Electrium-Mobility/power-distribution-antispark/Power_Distribution_Antispark.kicad_pcb

## KiCad design Power_Distribution_Antispark.kicad_pcb (2026-06-22)

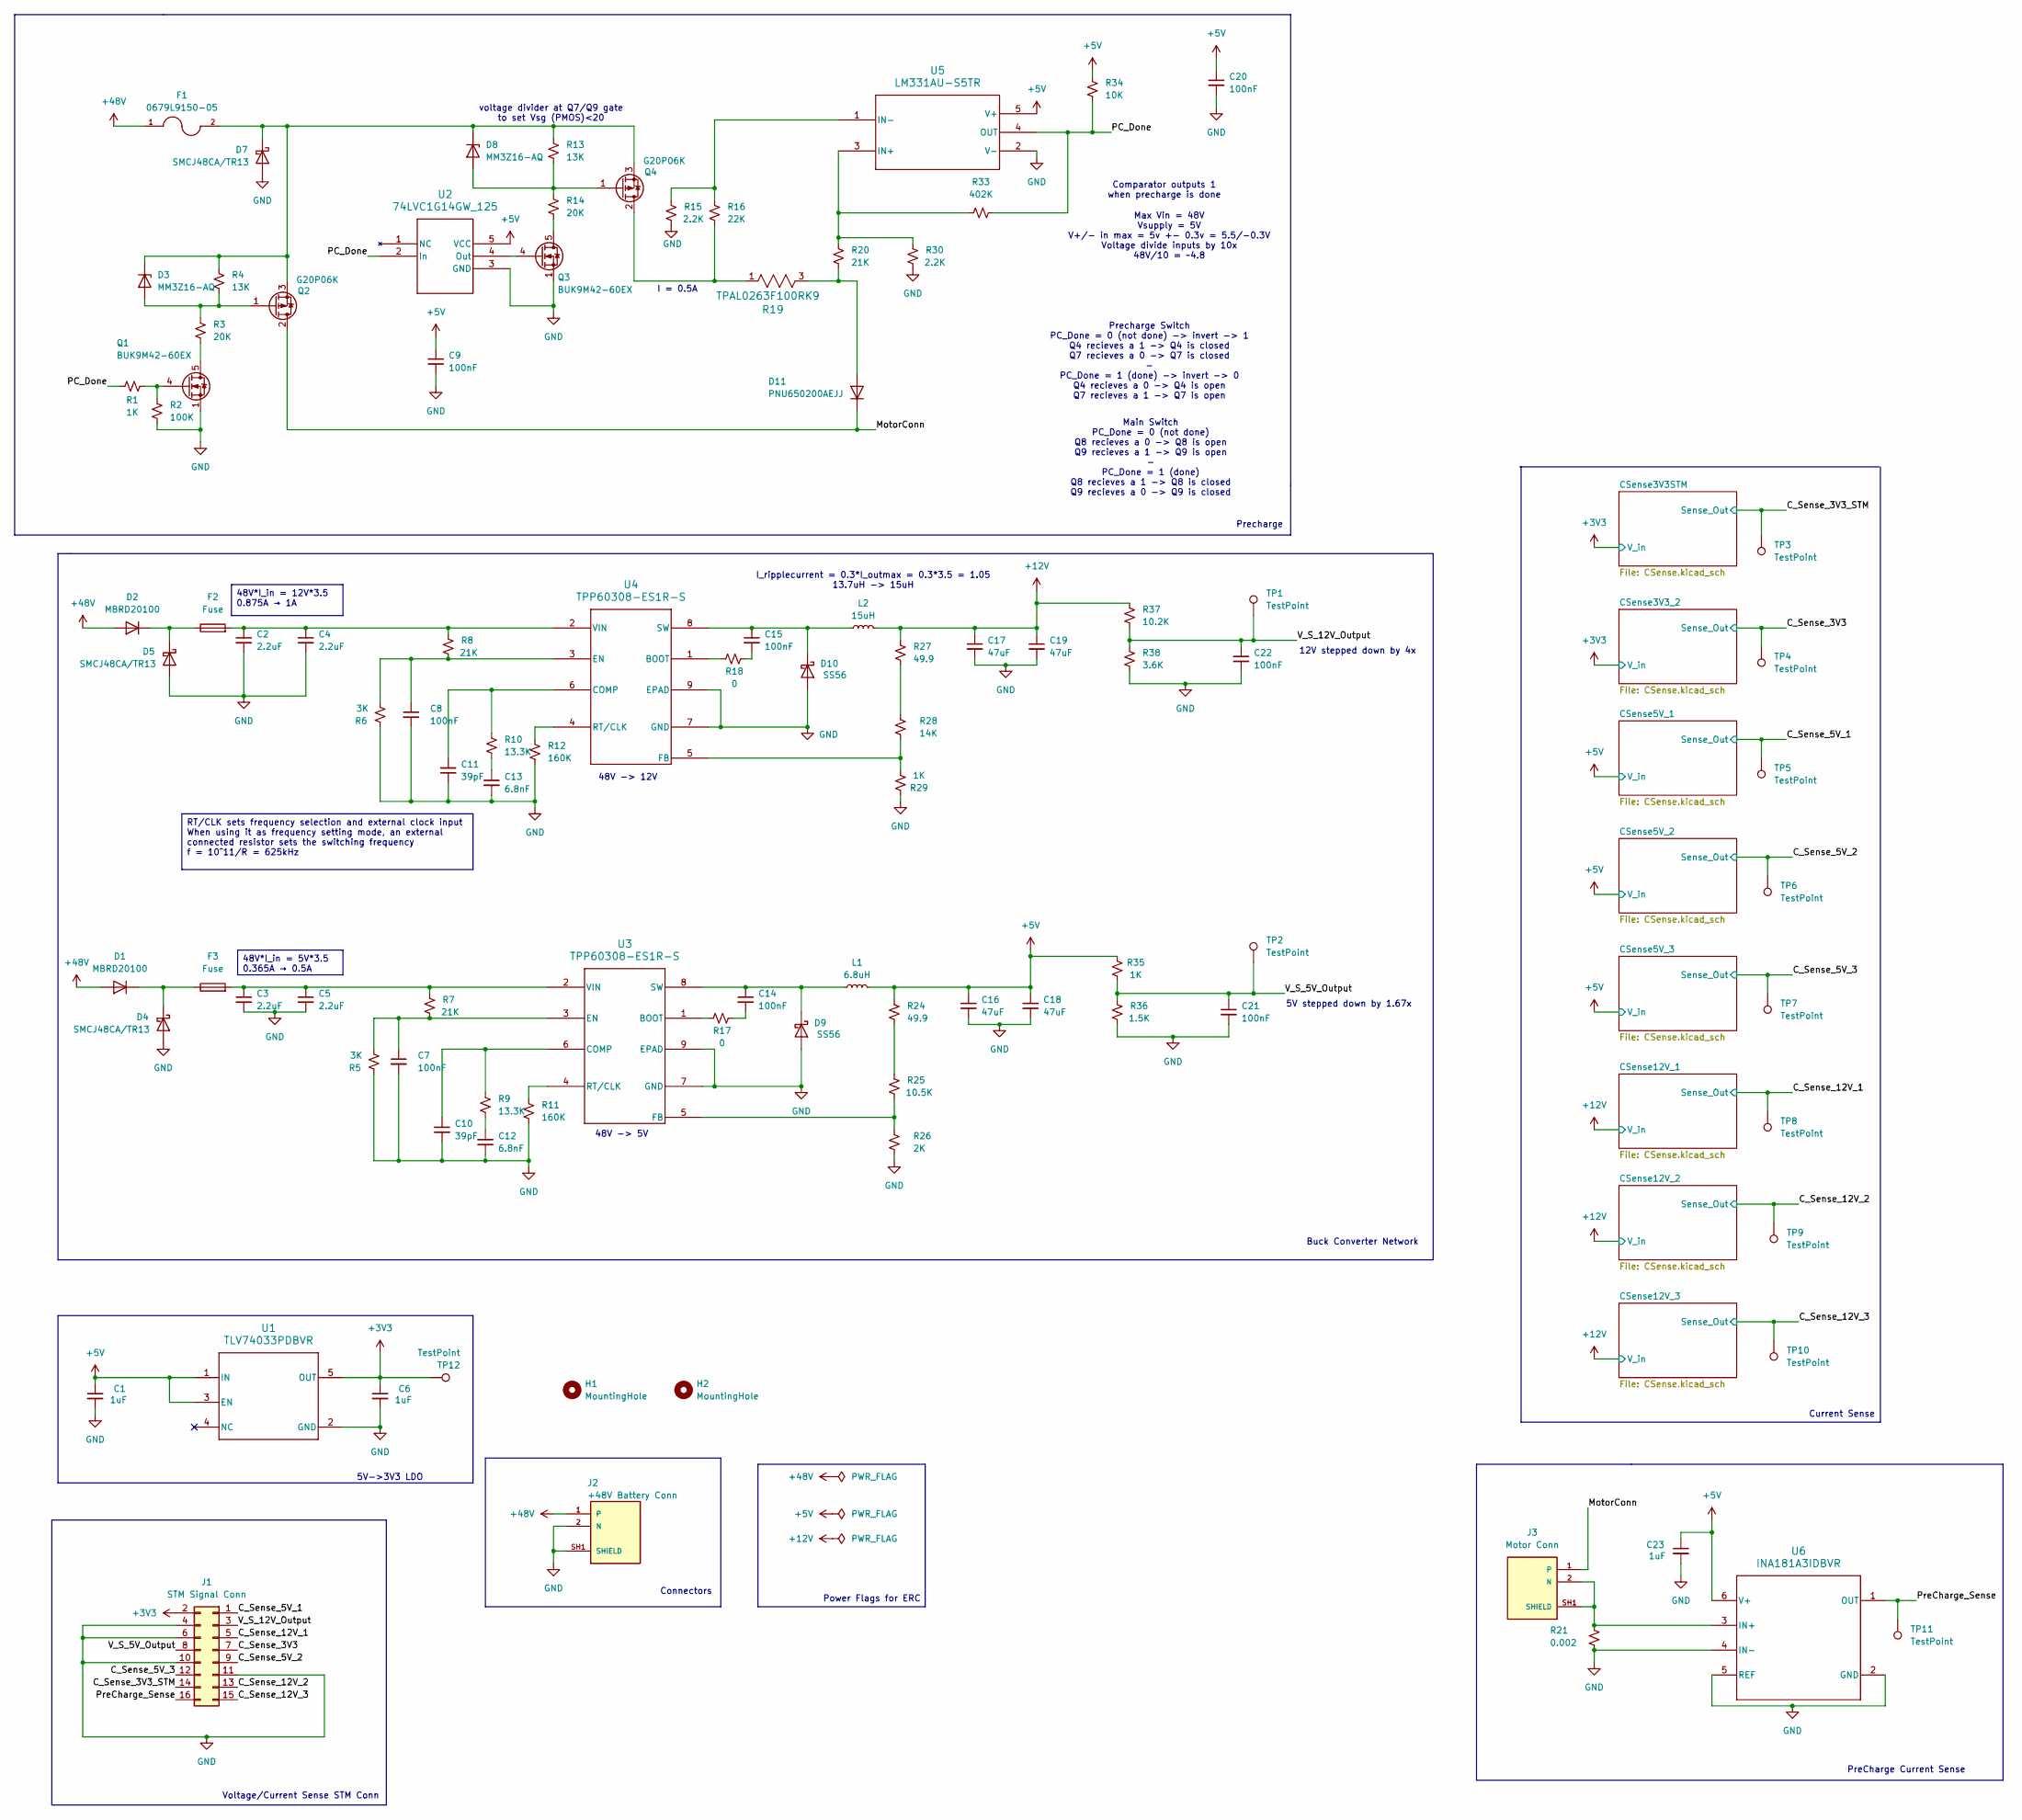
[picture p1: schematic Power_Distribution_Antispark.kicad_sch, Power Distribution Antispark]

Parts:
C1, C6, C23: 1uF; C_0603_1608Metric
C2, C3, C4, C5: 2.2uF; C_1206_3216Metric
C7, C8, C9, C14, C15, C20, C21, C22: 100nF; C_0603_1608Metric
C10, C11: 39pF; C_0603_1608Metric
C12, C13: 6.8nF; C_0603_1608Metric
C16, C17, C18, C19: 47uF; C_1206_3216Metric
D1, D2: MBRD20100; TO-252-3_TabPin2
D3, D8: MM3Z16-AQ; D_SOD-323F
D4, D5, D7: SMCJ48CA/TR13; D_SMC
D9, D10: SS56; D_SMA
D11: PNU650200AEJJ; TO-263-3_TabPin2
F1: 0679L9150-05; FUSE_0679L9200-05_BEL; PARTREV 0679H Apr2019
F2, F3: Fuse; Fuse_0603_1608Metric
H1, H2: MountingHole; MountingHole_2.5mm
J1: STM Signal Conn; CONN16_B16B-PHDSS_JST
J2: +48V Battery Conn; AMASS_XT60PW-F; PARTREV 1.2
J3: Motor Conn; AMASS_XT60PW-F; PARTREV 1.2
L1: 6.8uH; IND_MGAH06036R8M-10
L2: 15uH; IND_AMRM00101040_PUL-AMRM00101040150MA1
Q1, Q3: BUK9M42-60EX; LFPAK33
Q2, Q4: G20P06K; TO-252-3_TabPin2
R1, R29, R35: 1K; R_0603_1608Metric
R2: 100K; R_0603_1608Metric
R3, R14: 20K; R_0603_1608Metric
R4, R13: 13K; R_0603_1608Metric
R5, R6: 3K; R_0603_1608Metric
R7, R8, R20: 21K; R_0603_1608Metric
R9, R10: 13.3K; R_0603_1608Metric
R11, R12: 160K; R_0603_1608Metric
R15, R30: 2.2K; R_0603_1608Metric
R16: 22K; R_0603_1608Metric
R17, R18: 0; R_0603_1608Metric
R19: TPAL0263F100RK9; TO-263-2
R21: 0.002; R_0805_2012Metric
R24, R27: 49.9; R_0603_1608Metric
R25: 10.5K; R_0603_1608Metric
R26: 2K; R_0603_1608Metric
R28: 14K; R_0603_1608Metric
R33: 402K; R_0603_1608Metric
R34: 10K; R_0603_1608Metric
R36: 1.5K; R_0603_1608Metric
R37: 10.2K; R_0603_1608Metric
R38: 3.6K; R_0603_1608Metric
TP1, TP2, TP3, TP4, TP5, TP6, TP7, TP8, TP9, TP10, TP11, TP12: TestPoint; TestPoint_Pad_D1.0mm
U1: TLV74033PDBVR
U2: 74LVC1G14GW_125; SOT353_NEX
U3, U4: TPP60308-ES1R-S; ES1ESOP-8-F_TPK
U5: LM331AU-S5TR; S5TSOT23-5-A_TPK
U6: INA181A3IDBVR

Connections:
+3V3: C6.1, J1.2, TP12.1, U1.5 (OUT); also elsewhere on the board
+5V: C1.1, C9.1, C16.1, C18.1, C20.1, C23.1, L1.2, R24.1, R34.1, R35.2, U1.1 (IN), U1.3 (EN), U2.5 (VCC), U5.5 (V+), U6.6 (V+); also elsewhere on the board
+12V: C17.1, C19.1, L2.2, R27.1, R37.1; also elsewhere on the board
+48V: D1.2 (A), D2.2 (A), F1.1, J2.1
/C_Sense_3V3: J1.7, TP4.1; also elsewhere on the board
/C_Sense_3V3_STM: J1.14, TP3.1; also elsewhere on the board
/C_Sense_5V_1: J1.1, TP5.1; also elsewhere on the board
/C_Sense_5V_2: J1.9, TP6.1; also elsewhere on the board
/C_Sense_5V_3: J1.12, TP7.1; also elsewhere on the board
/C_Sense_12V_1: J1.5, TP8.1; also elsewhere on the board
/C_Sense_12V_2: J1.13, TP9.1; also elsewhere on the board
/C_Sense_12V_3: J1.15, TP10.1; also elsewhere on the board
/MotorConn: D11.1 (K), J3.1, Q2.2 (D)
/PC_Done: R1.1, R33.2, R34.2, U2.2 (In), U5.4 (OUT)
/PreCharge_Sense: J1.16, TP11.1, U6.1 (OUT)
/V_S_5V_Output: C21.1, J1.8, R35.1, R36.2, TP2.1
/V_S_12V_Output: C22.1, J1.3, R37.2, R38.1, TP1.1
GND: C1.2, C2.2, C3.2, C4.2, C5.2, C6.2, C7.2, C8.2, C9.2, C10.2, C11.2, C12.2, C13.2, C16.2, C17.2, C18.2, C19.2, C20.2, C21.2, C22.2, C23.2, D4.2 (A), D5.2 (A), D7.2 (A), D9.2 (A), D10.2 (A), J1.4, J1.6, J1.10, J1.11, J2.2 (N), J2.SH1 (SHIELD), J2.SH2 (SHIELD), Q1.1 (S), Q1.2 (S), Q1.3 (S), Q3.1 (S), Q3.2 (S), Q3.3 (S), R2.1, R5.2, R6.2, R11.2, R12.2, R15.1, R21.2, R26.2, R29.1, R30.1, R36.1, R38.2, U1.2 (GND), U2.3 (GND), U3.7 (GND), U3.9 (EPAD), U4.7 (GND), U4.9 (EPAD), U5.2 (V-), U6.2 (GND), U6.4 (IN-), U6.5 (REF); also elsewhere on the board
unnamed: C12.1, R9.2
unnamed: C13.1, R10.2
unnamed: C14.2, R17.2
unnamed: C15.2, R18.2
unnamed: D1.1 (K), D4.1 (K), F3.1
unnamed: D2.1 (K), D5.1 (K), F2.1
unnamed: D3.2 (A), Q2.1 (G), R3.2, R4.2
unnamed: D3.1 (K), D7.1 (K), D8.1 (K), F1.2, Q2.3 (S), Q4.3 (S), R4.1, R13.1
unnamed: D8.2 (A), Q4.1 (G), R13.2, R14.2
unnamed: C14.1, D9.1 (K), L1.1, U3.8 (SW)
unnamed: C15.1, D10.1 (K), L2.1, U4.8 (SW)
unnamed: D11.2 (A), R19.3, R20.1
unnamed: J3.2 (N), J3.SH1 (SHIELD), J3.SH2 (SHIELD), R21.1, U6.3 (IN+)
unnamed: Q1.5 (D), R3.1
unnamed: Q1.4 (G), R1.2, R2.2
unnamed: Q3.5 (D), R14.1
unnamed: Q3.4 (G), U2.4 (Out)
unnamed: Q4.2 (D), R16.1, R19.1
unnamed: R24.2, R25.2
unnamed: R27.2, R28.1
unnamed: R17.1, U3.1 (BOOT)
unnamed: C10.1, R9.1, U3.6 (COMP)
unnamed: C7.1, R5.1, R7.1, U3.3 (EN)
unnamed: R25.1, R26.1, U3.5 (FB)
unnamed: R11.1, U3.4 (RT/CLK)
unnamed: C3.1, C5.1, F3.2, R7.2, U3.2 (VIN)
unnamed: R18.1, U4.1 (BOOT)
unnamed: C11.1, R10.1, U4.6 (COMP)
unnamed: C8.1, R6.1, R8.1, U4.3 (EN)
unnamed: R28.2, R29.2, U4.5 (FB)
unnamed: R12.1, U4.4 (RT/CLK)
unnamed: C2.1, C4.1, F2.2, R8.2, U4.2 (VIN)
unnamed: R20.2, R30.2, R33.1, U5.3 (IN+)
unnamed: R15.2, R16.2, U5.1 (IN-)

Notes on the sheet:
48V -> 5V
12V stepped down by 4x
Connectors
I_ripplecurrent = 0.3*I_outmax = 0.3*3.5 = 1.05 13.7uH -> 15uH
Comparator outputs 1 when precharge is done
Precharge
Precharge Switch PC_Done = 0 (not done) -> invert -> 1 Q4 recieves a 1 -> Q4 is closed Q7 recieves a 0 -> Q7 is closed - PC_Done = 1 (done) -> invert -> 0 Q4 recieves a 0 -> Q4 is open Q7 recieves a 1 -> Q7 is open
voltage divider at Q7/Q9 gate to set Vsg (PMOS)<20
Buck Converter Network
Power Flags for ERC
Voltage/Current Sense STM Conn
Max Vin = 48V Vsupply = 5V V+/- in max = 5v +- 0.3v = 5.5/-0.3V Voltage divide inputs by 10x 48V/10 = ~4.8
48V -> 12V
Current Sense
Main Switch PC_Done = 0 (not done) Q8 recieves a 0 -> Q8 is open Q9 recieves a 1 -> Q9 is open - PC_Done = 1 (done) Q8 recieves a 1 -> Q8 is closed Q9 recieves a 0 -> Q9 is closed
I = 0.5A
5V stepped down by 1.67x
PreCharge Current Sense
5V->3V3 LDO
RT/CLK sets frequency selection and external clock input When using it as frequency setting mode, an external connected resistor sets the switching frequency f = 10^11/R = 625kHz
48V*I_in = 12V*3.5 0.875A → 1A
48V*I_in = 5V*3.5 0.365A → 0.5A

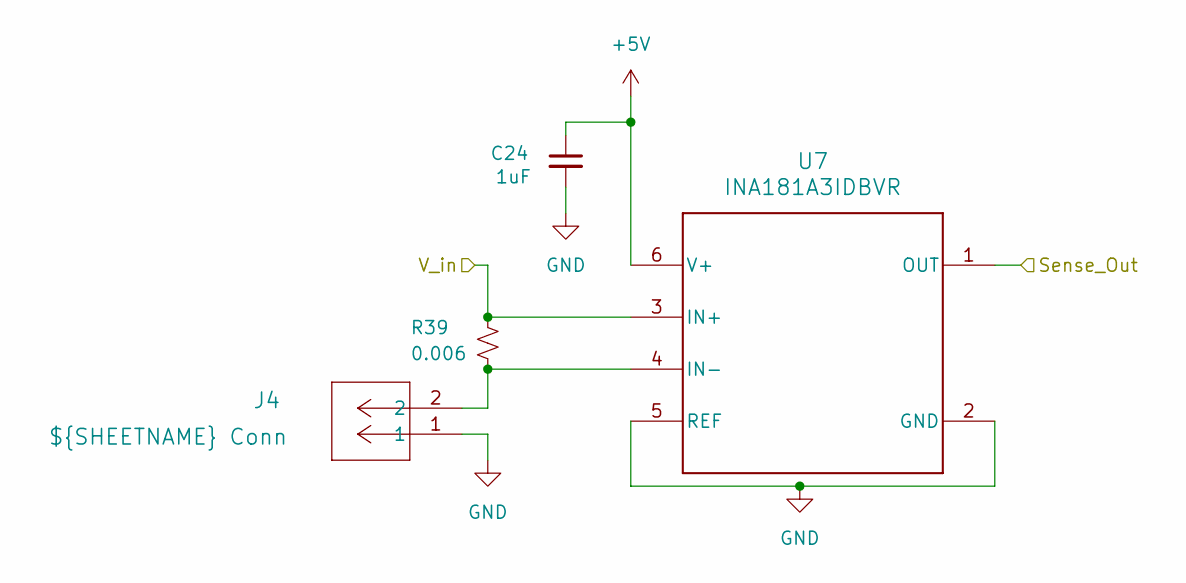
[picture p2: schematic CSense.kicad_sch]

Parts:
C24: 1uF; C_0603_1608Metric
J4: ${SHEETNAME} Conn; CONN_B2B-ZR_02P_JST
R39: 0.006; R_0805_2012Metric
U7: INA181A3IDBVR

Connections:
+3V3: R39.1, U7.3 (IN+); also elsewhere on the board
+5V: C24.1, U7.6 (V+); also elsewhere on the board
/C_Sense_3V3_STM: U7.1 (OUT); also elsewhere on the board
GND: C24.2, J4.1, U7.2 (GND), U7.5 (REF); also elsewhere on the board
unnamed: J4.2, R39.2, U7.4 (IN-)

Parts of its further copies:
C25, C26, C27, C28, C29, C30, C31: 1uF; C_0603_1608Metric
R40, R41, R42, R43, R44, R45, R46: 0.006; R_0805_2012Metric
U8, U9, U10, U11, U12, U13, U14: INA181A3IDBVR

Connections of its further copies:
+3V3: R40.1, U8.3 (IN+); also elsewhere on the board
+5V: C25.1, C26.1, C27.1, C28.1, C29.1, C30.1, C31.1, R41.1, R42.1, R43.1, U8.6 (V+), U9.3 (IN+), U9.6 (V+), U10.3 (IN+), U10.6 (V+), U11.3 (IN+), U11.6 (V+), U12.6 (V+), U13.6 (V+), U14.6 (V+); also elsewhere on the board
+12V: R44.1, R45.1, R46.1, U12.3 (IN+), U13.3 (IN+), U14.3 (IN+); also elsewhere on the board
/C_Sense_3V3: U8.1 (OUT); also elsewhere on the board
/C_Sense_5V_1: U9.1 (OUT); also elsewhere on the board
/C_Sense_5V_2: U10.1 (OUT); also elsewhere on the board
/C_Sense_5V_3: U11.1 (OUT); also elsewhere on the board
/C_Sense_12V_1: U12.1 (OUT); also elsewhere on the board
/C_Sense_12V_2: U13.1 (OUT); also elsewhere on the board
/C_Sense_12V_3: U14.1 (OUT); also elsewhere on the board
GND: C25.2, C26.2, C27.2, C28.2, C29.2, C30.2, C31.2, U8.2 (GND), U8.5 (REF), U9.2 (GND), U9.5 (REF), U10.2 (GND), U10.5 (REF), U11.2 (GND), U11.5 (REF), U12.2 (GND), U12.5 (REF), U13.2 (GND), U13.5 (REF), U14.2 (GND), U14.5 (REF); also elsewhere on the board
unnamed 53: R40.2, U8.4 (IN-); also elsewhere on the board
unnamed 54: R41.2, U9.4 (IN-); also elsewhere on the board
unnamed 55: R42.2, U10.4 (IN-); also elsewhere on the board
unnamed 56: R43.2, U11.4 (IN-); also elsewhere on the board
unnamed 57: R44.2, U12.4 (IN-); also elsewhere on the board
unnamed 58: R45.2, U13.4 (IN-); also elsewhere on the board
unnamed 59: R46.2, U14.4 (IN-); also elsewhere on the board

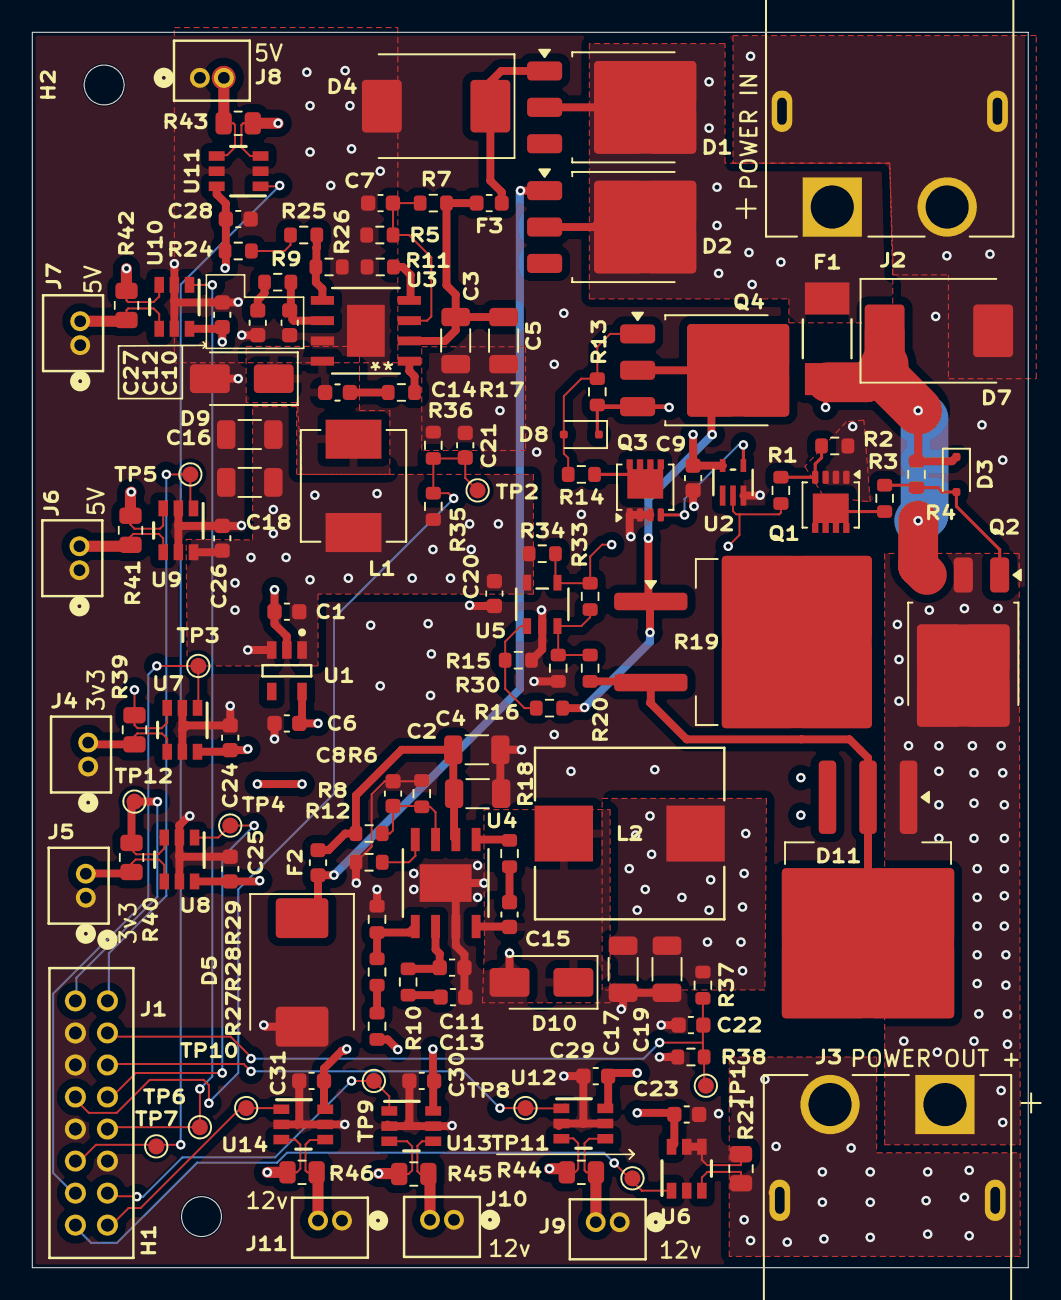
[picture p3: board Power_Distribution_Antispark.kicad_pcb from above]

Board: 4 copper layers, 62.4 x 77.4 mm, 131 parts (0 on the bottom side), 60 nets.

Other parts of the board:
J5: CSense3V3_2 Conn; CONN_B2B-ZR_02P_JST
J6: CSense5V_1 Conn; CONN_B2B-ZR_02P_JST
J7: CSense5V_2 Conn; CONN_B2B-ZR_02P_JST
J8: CSense5V_3 Conn; CONN_B2B-ZR_02P_JST
J9: CSense12V_1 Conn; CONN_B2B-ZR_02P_JST
J10: CSense12V_2 Conn; CONN_B2B-ZR_02P_JST
J11: CSense12V_3 Conn; CONN_B2B-ZR_02P_JST

Their connections:
GND: J5.1, J6.1, J7.1, J8.1, J9.1, J10.1, J11.1; also elsewhere on the board
unnamed 53: J5.2; also elsewhere on the board
unnamed 54: J6.2; also elsewhere on the board
unnamed 55: J7.2; also elsewhere on the board
unnamed 56: J8.2; also elsewhere on the board
unnamed 57: J9.2; also elsewhere on the board
unnamed 58: J10.2; also elsewhere on the board
unnamed 59: J11.2; also elsewhere on the board
