Electrium-Mobility/power-distribution-antispark/(commit log)

2026-05-27 schematic without gate driver
    [Power_Distribution_Antispark.kicad_sch]
2026-05-27 schematic without resistor cap ind
    [Power_Distribution_Antispark.kicad_sch]
2026-05-27 schematic without inductor
    [Power_Distribution_Antispark.kicad_sch]
2026-05-28 schematic for review
    [Power_Distribution_Antispark.kicad_sch]
2026-05-28 schematic fixed precharge logic
    still need to spec inverter
    [Power_Distribution_Antispark.kicad_sch]
2026-05-28 updated connectors and inverter
    [Power_Distribution_Antispark.kicad_sch]
2026-05-28 updated connectors
    [Power_Distribution_Antispark.kicad_sch]
2026-05-31 schematic update
    [CSense.kicad_sch, Power_Distribution_Antispark.kicad_sch]
2026-05-31 changed ldo to buck
    [Power_Distribution_Antispark.kicad_sch]
2026-05-31 added pull up resistor for comparator
    [Power_Distribution_Antispark.kicad_sch]
2026-06-01 final schematic
    [CSense.kicad_sch, Power_Distribution_Antispark.kicad_sch]
2026-06-09 damir review
    [CSense.kicad_sch, Power_Distribution_Antispark.kicad_sch]
2026-06-10 tweaked comparator resistor values
    [Power_Distribution_Antispark.kicad_sch]
2026-06-10 tweaked comparator values and shunt
    [Power_Distribution_Antispark.kicad_sch]
2026-06-10 minor component datasheet fix + layout started
    [Power_Distribution_Antispark.kicad_pcb, Power_Distribution_Antispark.kicad_sch]
2026-06-11 component layout
    [Power_Distribution_Antispark.kicad_pcb, Power_Distribution_Antispark.kicad_sch]
2026-06-11 layout changes
    [Power_Distribution_Antispark.kicad_pcb]
2026-06-11 redid layout components
    [Power_Distribution_Antispark.kicad_pcb]
2026-06-12 most traces
    [Power_Distribution_Antispark.kicad_pcb]
2026-06-12 all traces
    [Power_Distribution_Antispark.kicad_pcb, Power_Distribution_Antispark.kicad_sch]
2026-06-12 updated traces
    [Power_Distribution_Antispark.kicad_pcb]
2026-06-14 layout review + fixed polygon pour shapes
    [Power_Distribution_Antispark.kicad_pcb]
2026-06-14 layout update
    [Power_Distribution_Antispark.kicad_pcb]
2026-06-16 layout post review
    [Power_Distribution_Antispark.kicad_pcb]
2026-06-18 fixed silkscreens
    [Power_Distribution_Antispark.kicad_pcb, Power_Distribution_Antispark.kicad_sch]
2026-06-19 fixed connectors
    [CSense.kicad_sch, Power_Distribution_Antispark.kicad_pcb, Power_Distribution_Antispark.kicad_sch]
2026-06-19 fixed leo layout review
    [Power_Distribution_Antispark.kicad_pcb]
2026-06-21 final layout + logo added
    [Power_Distribution_Antispark.kicad_pcb]
2026-06-22 added date and rev number
    [Power_Distribution_Antispark.kicad_pcb]
2026-06-29 changed main pmos
    [Power_Distribution_Antispark.kicad_sch]
